purduerov/XX-Power-Distribution/Power-Conversion.brd

## EAGLE design Power-Conversion.brd (2018-02-15)

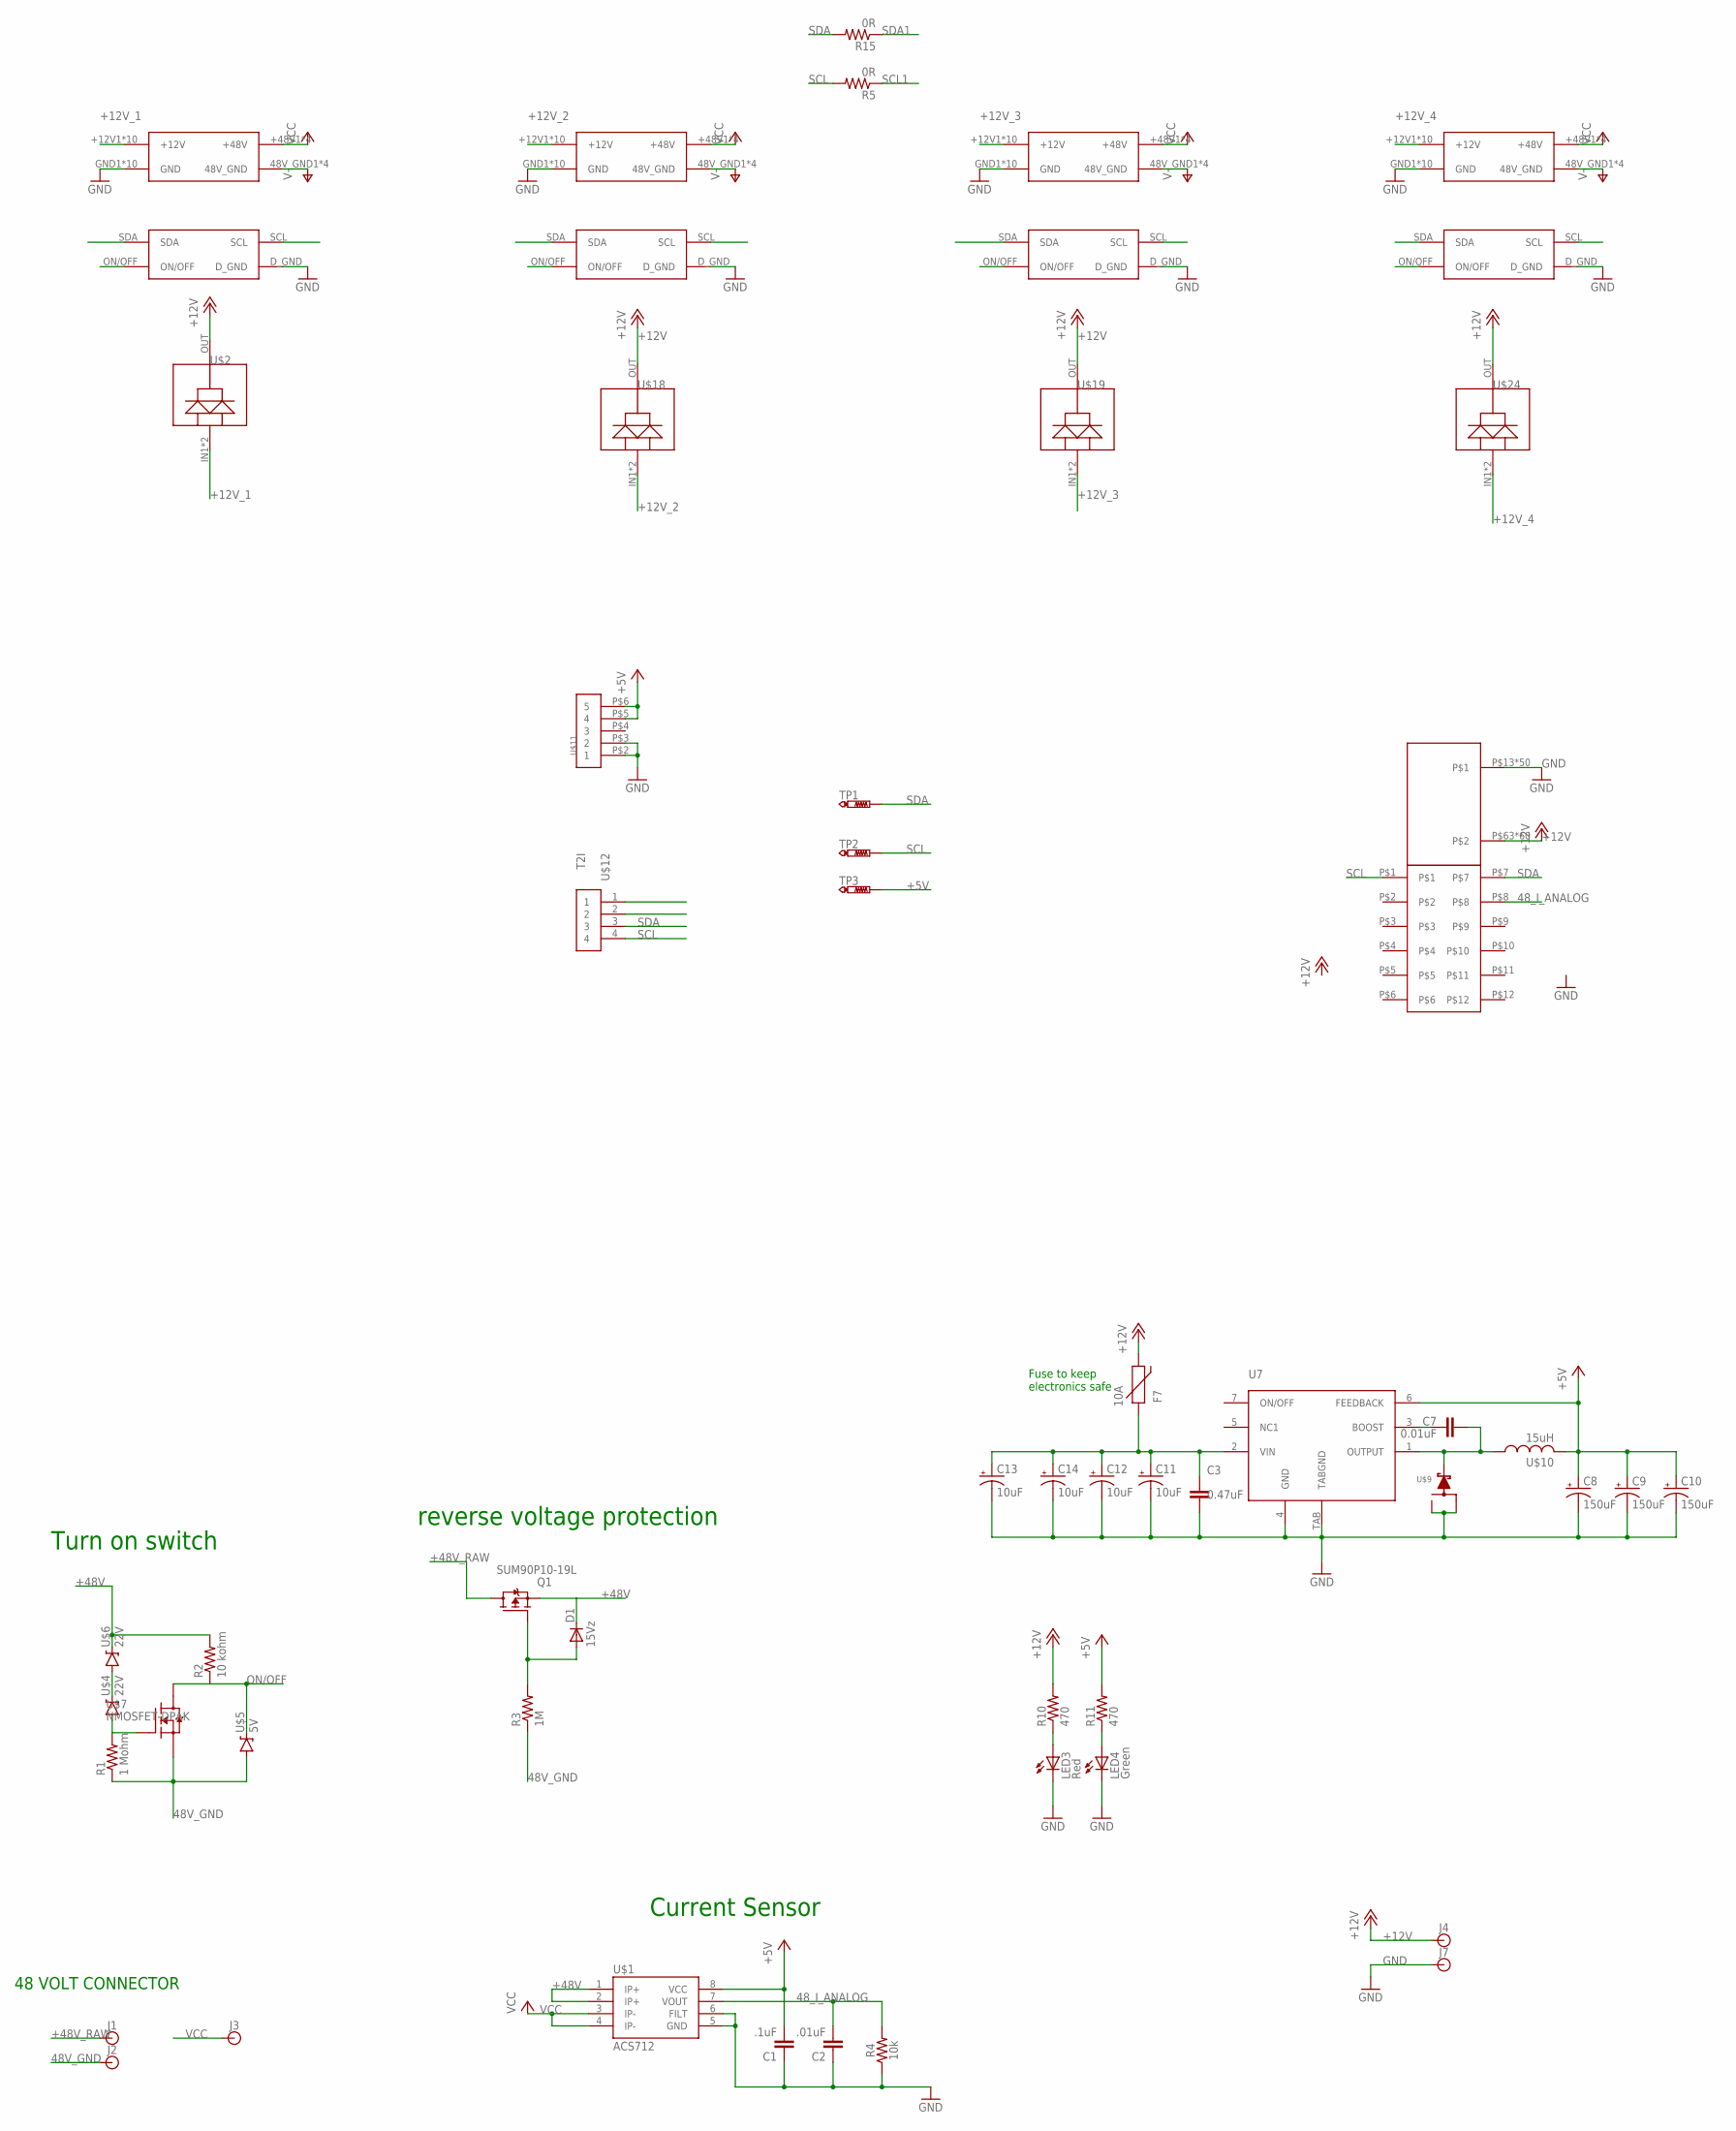
[picture p1: schematic Power-Conversion.sch]

Parts:
C1: .1uF; 0603
C2: .01uF; 0603
C3: 0.47uF; C0603
C7: 0.01uF; 0603-CAP
C8, C9, C10: 150uF; CTAN(7.30_4.30MM)
C11, C12, C13, C14: 10uF; CTAN(7.30_4.30MM)
D1: 15Vz; SOD123; PARTNO MMSZ5245BFSCT-ND
F7: 10A; PTC-2920
J1, J2, J3, J4, J7: BANANA_CONN
LED3: Red; LED-0603
LED4: Green; LED-0603
Q1: SUM90P10-19L; TO263; PARTNO SUM90P10-19L-E3CT-ND
R1: 1 Mohm; 0603-RES
R2: 10 kohm; 0603-RES
R3: 1M; R0603; PARTNO 1.00MHCT-ND
R4: 10k; 0603
R5, R15: 0R; R0603
R10, R11: 470; R0603
TP1, TP2, TP3: PTR1PAD1-13; P1-13
U7: LM2678
U$1: ACS712; SO08
U$2, U$18, U$19, U$24: DIODE
U$4, U$6: 22V; SOT23-3
U$5: 5V; SOT23-3
U$7: NMOSFET-DPAK; DPAK
U$8: ESC-FULL
U$9: SWITCHMODE_SCHOTTKY; DPAK-3
U$10: 15uH; HCMA1305
U$11: T2I5P
U$12: T2I
U$20, U$21, U$22, U$23: BRICK_TO_POWER_DIST_WHOLE

Connections:
48V_GND: J2.P$1, R1.1, R3.1, U$5.1 (A), U$7.3 (S), U$20.48V_GND1 (48V_GND), U$20.48V_GND2 (48V_GND), U$20.48V_GND3 (48V_GND), U$20.48V_GND4 (48V_GND), U$21.48V_GND1 (48V_GND), U$21.48V_GND2 (48V_GND), U$21.48V_GND3 (48V_GND), U$21.48V_GND4 (48V_GND), U$22.48V_GND1 (48V_GND), U$22.48V_GND2 (48V_GND), U$22.48V_GND3 (48V_GND), U$22.48V_GND4 (48V_GND), U$23.48V_GND1 (48V_GND), U$23.48V_GND2 (48V_GND), U$23.48V_GND3 (48V_GND), U$23.48V_GND4 (48V_GND)
48_I_ANALOG: C2.2, R4.2, U$1.7 (VOUT), U$8.P$8
+5V: C1.2, C8.+, C9.+, C10.+, R11.2, TP3.TP, U7.6 (FEEDBACK), U$1.8 (VCC), U$10.P$2 (2), U$11.P$5 (4), U$11.P$6 (5)
+12V: F7.2, J4.P$1, R10.2, U$2.OUT, U$8.P$63, U$8.P$64, U$8.P$65, U$8.P$66, U$8.P$67, U$8.P$68, U$8.P$69, U$8.P$70, U$8.P$71, U$8.P$72, U$8.P$73, U$8.P$74, U$8.P$75, U$8.P$76, U$8.P$77, U$8.P$78, U$8.P$79, U$8.P$80, U$8.P$81, U$8.P$82, U$8.P$83, U$8.P$84, U$8.P$85, U$8.P$86, U$8.P$87, U$8.P$88, U$8.P$89, U$8.P$90, U$8.P$91, U$8.P$92, U$8.P$101, U$8.P$102, U$8.P$103, U$8.P$104, U$8.P$105, U$8.P$106, U$8.P$107, U$8.P$108, U$8.P$109, U$8.P$110, U$8.P$111, U$8.P$112, U$8.P$113, U$8.P$114, U$8.P$115, U$8.P$116, U$8.P$117, U$8.P$118, U$8.P$119, U$8.P$120, U$8.P$121, U$8.P$122, U$8.P$123, U$8.P$124, U$8.P$125, U$8.P$126, U$8.P$127, U$8.P$128, U$8.P$129, U$8.P$130, U$18.OUT, U$19.OUT, U$24.OUT
+12V_1: U$2.IN1 (IN2), U$2.IN2, U$20.+12V1 (+12V), U$20.+12V2 (+12V), U$20.+12V3 (+12V), U$20.+12V4 (+12V), U$20.+12V5 (+12V), U$20.+12V6 (+12V), U$20.+12V7 (+12V), U$20.+12V8 (+12V), U$20.+12V9 (+12V), U$20.+12V10 (+12V)
+12V_2: U$18.IN1 (IN2), U$18.IN2, U$21.+12V1 (+12V), U$21.+12V2 (+12V), U$21.+12V3 (+12V), U$21.+12V4 (+12V), U$21.+12V5 (+12V), U$21.+12V6 (+12V), U$21.+12V7 (+12V), U$21.+12V8 (+12V), U$21.+12V9 (+12V), U$21.+12V10 (+12V)
+12V_3: U$19.IN1 (IN2), U$19.IN2, U$22.+12V1 (+12V), U$22.+12V2 (+12V), U$22.+12V3 (+12V), U$22.+12V4 (+12V), U$22.+12V5 (+12V), U$22.+12V6 (+12V), U$22.+12V7 (+12V), U$22.+12V8 (+12V), U$22.+12V9 (+12V), U$22.+12V10 (+12V)
+12V_4: U$23.+12V1 (+12V), U$23.+12V2 (+12V), U$23.+12V3 (+12V), U$23.+12V4 (+12V), U$23.+12V5 (+12V), U$23.+12V6 (+12V), U$23.+12V7 (+12V), U$23.+12V8 (+12V), U$23.+12V9 (+12V), U$23.+12V10 (+12V), U$24.IN1 (IN2), U$24.IN2
+48V: D1.C, Q1.2 (S), R2.2, U$1.1 (IP+), U$1.2 (IP+), U$6.3 (C)
+48V_RAW: J1.P$1, Q1.3 (D)
GND: C1.1, C2.1, C3.2, C8.-, C9.-, C10.-, C11.-, C12.-, C13.-, C14.-, J7.P$1, LED3.C, LED4.C, R4.1, U7.4 (GND), U7.TAB (TABGND), U$1.5 (GND), U$1.6 (FILT), U$8.P$13, U$8.P$14, U$8.P$15, U$8.P$16, U$8.P$17, U$8.P$18, U$8.P$19, U$8.P$20, U$8.P$21, U$8.P$22, U$8.P$23, U$8.P$24, U$8.P$25, U$8.P$26, U$8.P$27, U$8.P$28, U$8.P$29, U$8.P$30, U$8.P$31, U$8.P$32, U$8.P$33, U$8.P$34, U$8.P$35, U$8.P$36, U$8.P$37, U$8.P$38, U$8.P$39, U$8.P$40, U$8.P$41, U$8.P$42, U$8.P$43, U$8.P$44, U$8.P$45, U$8.P$46, U$8.P$47, U$8.P$48, U$8.P$49, U$8.P$50, U$8.P$51, U$8.P$52, U$8.P$53, U$8.P$54, U$8.P$55, U$8.P$56, U$8.P$57, U$8.P$58, U$8.P$59, U$8.P$60, U$8.P$61, U$8.P$62, U$9.P$1, U$9.P$3, U$11.P$2 (1), U$11.P$3 (2), U$20.D_GND, U$20.GND1 (GND), U$20.GND2 (GND), U$20.GND3 (GND), U$20.GND4 (GND), U$20.GND5 (GND), U$20.GND6 (GND), U$20.GND7 (GND), U$20.GND8 (GND), U$20.GND9 (GND), U$20.GND10 (GND), U$21.D_GND, U$21.GND1 (GND), U$21.GND2 (GND), U$21.GND3 (GND), U$21.GND4 (GND), U$21.GND5 (GND), U$21.GND6 (GND), U$21.GND7 (GND), U$21.GND8 (GND), U$21.GND9 (GND), U$21.GND10 (GND), U$22.D_GND, U$22.GND1 (GND), U$22.GND2 (GND), U$22.GND3 (GND), U$22.GND4 (GND), U$22.GND5 (GND), U$22.GND6 (GND), U$22.GND7 (GND), U$22.GND8 (GND), U$22.GND9 (GND), U$22.GND10 (GND), U$23.D_GND, U$23.GND1 (GND), U$23.GND2 (GND), U$23.GND3 (GND), U$23.GND4 (GND), U$23.GND5 (GND), U$23.GND6 (GND), U$23.GND7 (GND), U$23.GND8 (GND), U$23.GND9 (GND), U$23.GND10 (GND)
unnamed: C3.1, C11.+, C12.+, C13.+, C14.+, F7.1, U7.2 (VIN)
unnamed: D1.A, Q1.1 (G), R3.2
unnamed: U$4.3 (C), U$6.1 (A)
unnamed: R1.2, U$4.1 (A), U$7.1 (G)
unnamed: C7.1, U7.3 (BOOST)
unnamed: C7.2, U7.1 (OUTPUT), U$9.P$4, U$10.P$1 (1)
unnamed: LED3.A, R10.1
unnamed: LED4.A, R11.1
ON/OFF: R2.1, U$5.3 (C), U$7.4 (D1), U$20.ON/OFF, U$21.ON/OFF, U$22.ON/OFF, U$23.ON/OFF
SCL: R5.2, TP2.TP, U$8.P$1, U$12.4
SCL1: R5.1, U$20.SCL, U$21.SCL, U$22.SCL, U$23.SCL
SDA: R15.2, TP1.TP, U$8.P$7, U$12.3
SDA1: R15.1, U$20.SDA, U$21.SDA, U$22.SDA, U$23.SDA
VCC: J3.P$1, U$1.3 (IP-), U$1.4 (IP-), U$20.+48V1 (+48V), U$20.+48V2 (+48V), U$20.+48V3 (+48V), U$20.+48V4 (+48V), U$21.+48V1 (+48V), U$21.+48V2 (+48V), U$21.+48V3 (+48V), U$21.+48V4 (+48V), U$22.+48V1 (+48V), U$22.+48V2 (+48V), U$22.+48V3 (+48V), U$22.+48V4 (+48V), U$23.+48V1 (+48V), U$23.+48V2 (+48V), U$23.+48V3 (+48V), U$23.+48V4 (+48V)

Notes on the sheet:
Turn on switch
reverse voltage protection
48 VOLT CONNECTOR
Current Sensor
Fuse to keep electronics safe

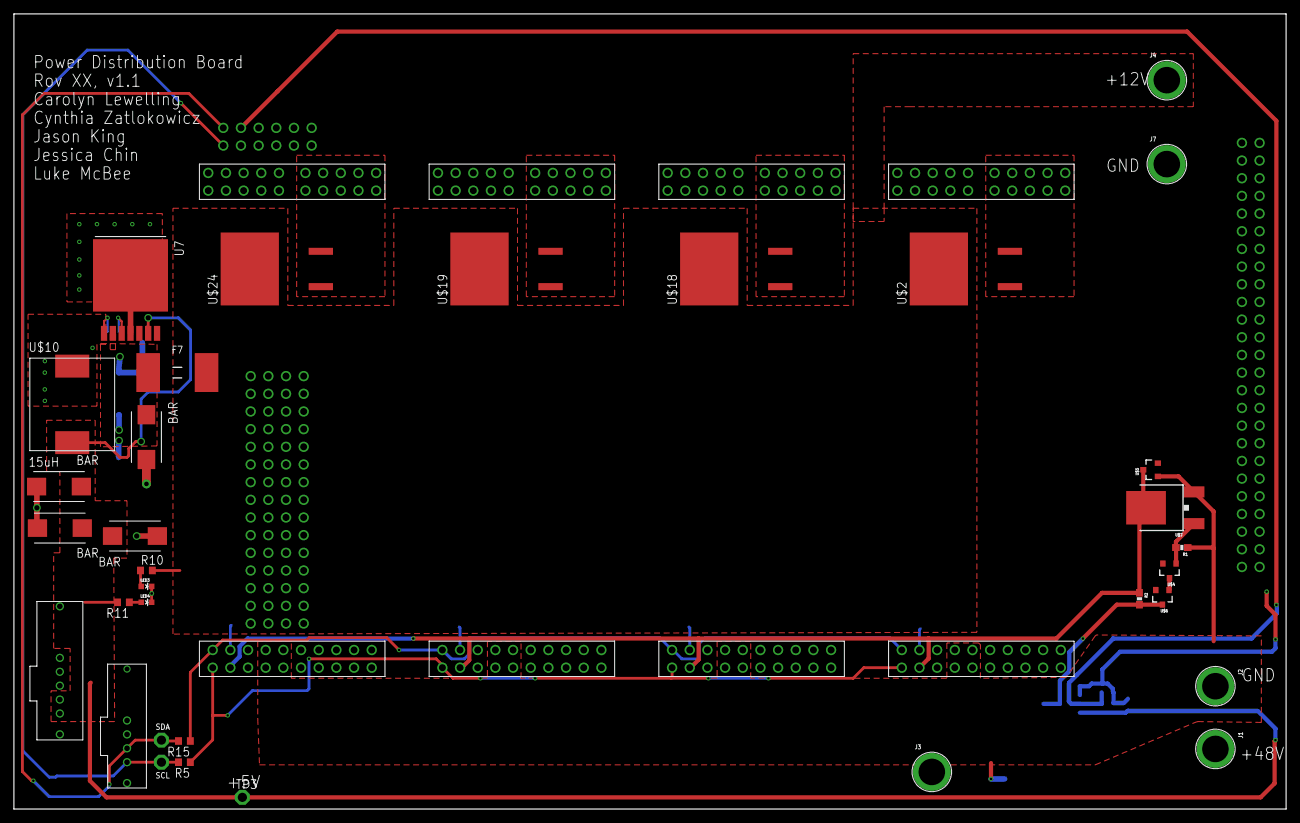
[picture p2: board Power-Conversion.brd from above]

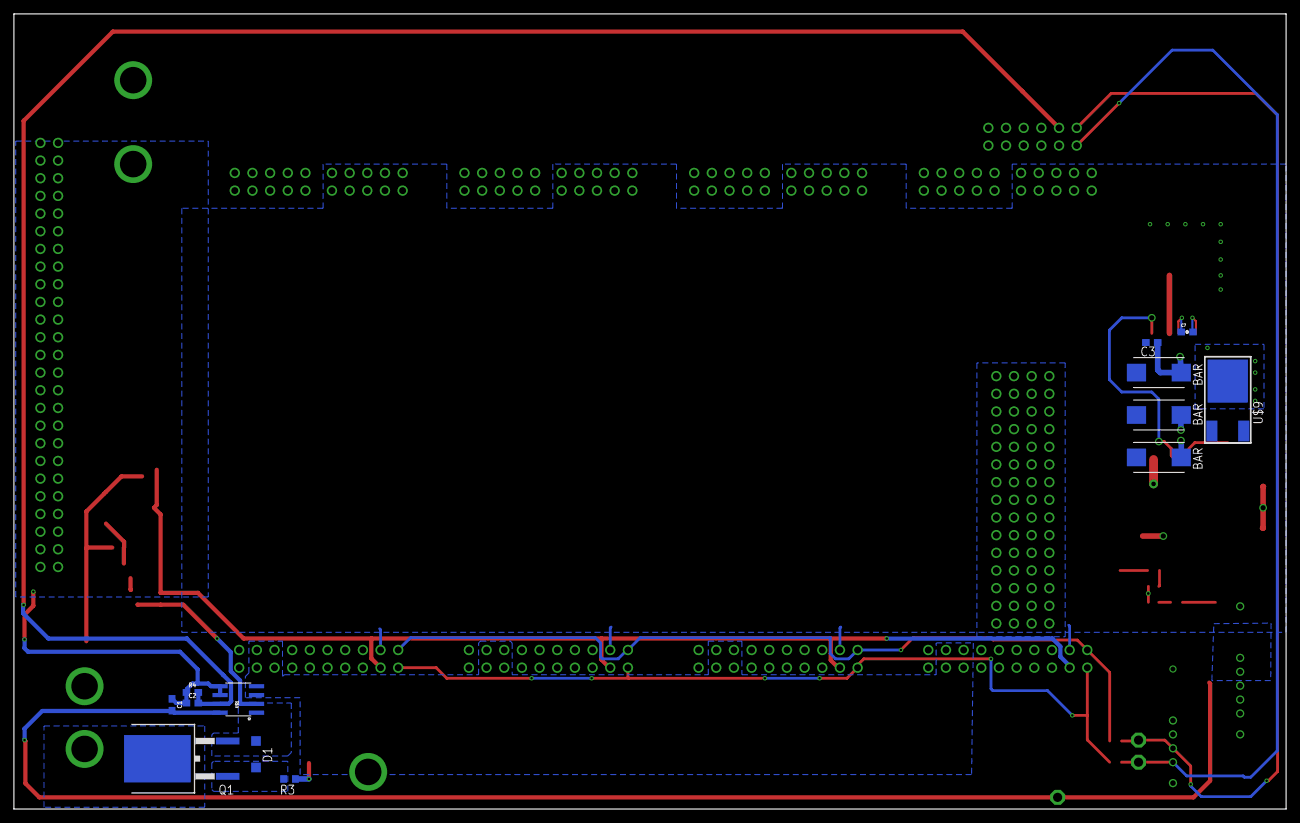
[picture p3: board Power-Conversion.brd from below]

Board: 2 copper layers, 182.9 x 114.3 mm, 52 parts (13 on the bottom side), 25 nets.

Other parts of the board:
U$15: POWER_DIST_TO_ESC
