purduerov/XX-Power-Distribution/(commit log)

2017-10-03 getting rid of old layout
    [Power-Conversion.brd]
2017-10-14 Added buck converter, reverse voltage protection, and turn on switch
    [Power-Conversion.brd]
2017-10-28 added current sense
    added current sense and support things
    [Power-Conversion.brd, Power-Conversion.sch]
2017-11-02 Added voltage connectors
    added the voltage connectors
    [Power-Conversion.brd, Power-Conversion.sch]
2017-11-10 added Connectors
    added connectors to schematic
    [Power-Conversion.sch]
2017-11-11 Added micro
    added the microcontroller.
    [Power-Conversion.sch]
2017-11-11 Added Connectors
    [Power-Conversion.sch]
2017-11-11 Removed micro
    removed micro controller and added capacitors to linear regelator
    [Power-Conversion.sch]
2017-11-17 Connected the connectors
    [Power-Conversion.sch]
2017-11-17 Started Board layout
    [Power-Conversion.brd, Power-Conversion.sch]
2017-12-01 Fix Board Layout
    [Power-Conversion.brd, Power-Conversion.sch]
2017-12-01 Routed Board
    Added Diodes
    [Power-Conversion.brd, Power-Conversion.sch]
2017-12-27 Added new connectors for 8th bricks
    [Power-Conversion.brd, Power-Conversion.sch]
2017-12-30 Initial layout of parts has begun. Still need to reduce down the size a lot...
    [Power-Conversion.brd, Power-Conversion.sch]
2017-12-30 Shrinking down the board more and figuring out part placement
    [Power-Conversion.brd, Power-Conversion.sch]
2018-01-01 Finalizing intial layout of parts
    [Power-Conversion.brd]
2018-01-01 Moved around parts to near final postions. Next comes routing.
    [Power-Conversion.brd, Power-Conversion.sch]
2018-01-01 Added fuse to 12V going to rasp pi
    [Power-Conversion.brd, Power-Conversion.sch]
2018-01-02 Got buck regulator done
    [Power-Conversion.brd]
2018-01-02 Added standard ESC board connector
    [Power-Conversion.brd, Power-Conversion.sch]
2018-01-02 Some routing done
    [Power-Conversion.brd, Power-Conversion.sch]
2018-01-08 finished board layout
    first draft board layout
    [Power-Conversion.brd, Power-Conversion.sch]
2018-01-08 Added new ESC to power distribution board part
    [Power-Conversion.brd, Power-Conversion.sch]
2018-01-08 Fixed to work with new connector part
    [Power-Conversion.brd, Power-Conversion.sch]
2018-01-08 Added silkscreen
    [Power-Conversion.brd]
2018-01-08 Fixed trace widths for +48V and GND
    [Power-Conversion.brd]
2018-01-08 Cleaning up
    [Power-Conversion.brd, Power-Conversion.sch]
2018-01-10 Version submitted to elecrow
    [Power-Conversion.brd, Power-Conversion.sch]
2018-01-31 Put in resistor values on ON/OFF switch
    on ON/OFF switch
    [Power-Conversion.brd, Power-Conversion.sch]
2018-02-13 Some changes for second round of manufacturing
    [Power-Conversion.brd, Power-Conversion.sch]
2018-02-13 Added isolation for every pour, fixed issue with inductor and fuse overlap, and labeled tantalum capacitors.
    [Power-Conversion.brd]
2018-02-15 changed kirby, version number, and erc issue
    Changed silkscreen & weird erc issue with J1 and J2
    [Power-Conversion.brd, Power-Conversion.sch]
2018-02-15 Added +5V test point, removed text from Kirby, modified connector to RPi so Power and GND dont overlap
    [Power-Conversion.brd, Power-Conversion.sch]
